revav07/Pulse-Oximeter-Project/Media/Prototype Images/Enclosure with Attached Straps.jpeg

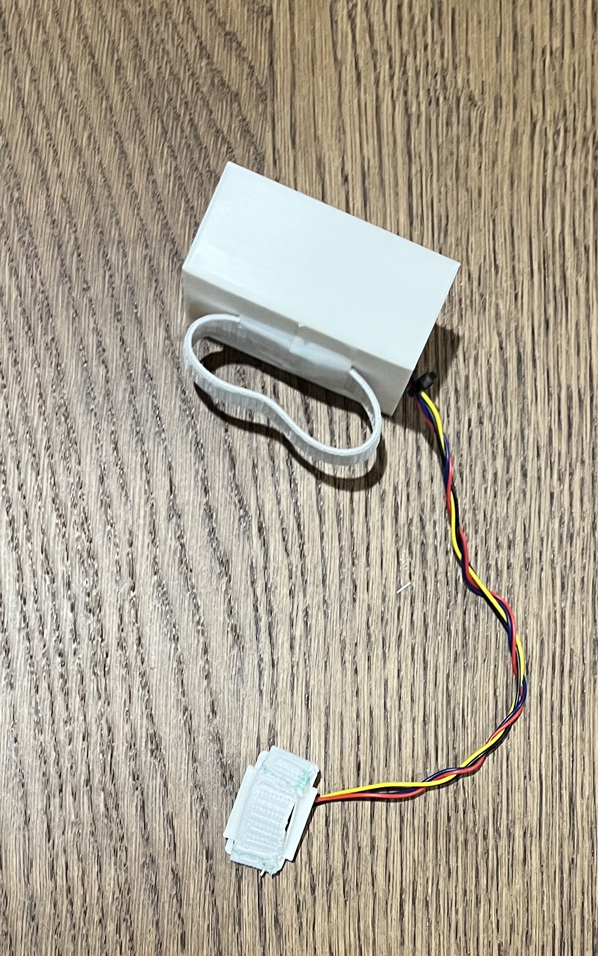
Media/Prototype Images/Enclosure with Attached Straps.jpeg
