revav07/Pulse-Oximeter-Project/Media/Prototype Images/ESP + Button.jpeg

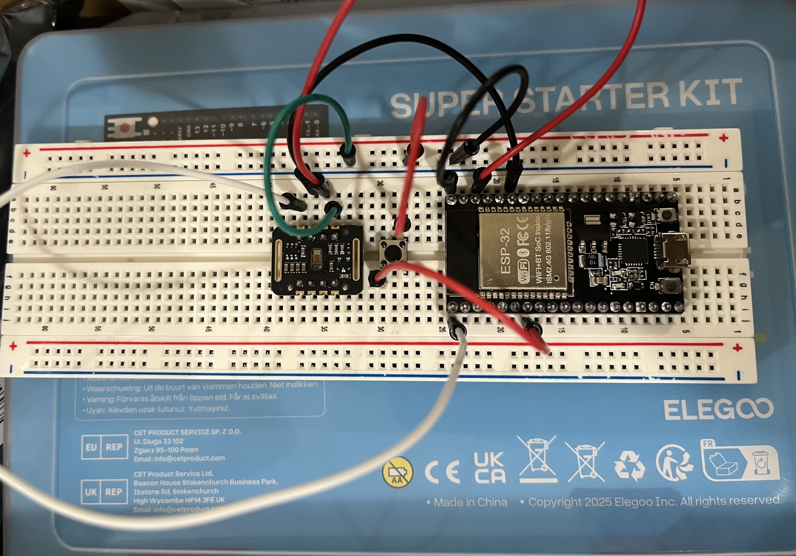
Media/Prototype Images/ESP + Button.jpeg
