revav07/Pulse-Oximeter-Project/Media/Prototype Images/Final 3D Printed Setup.jpeg

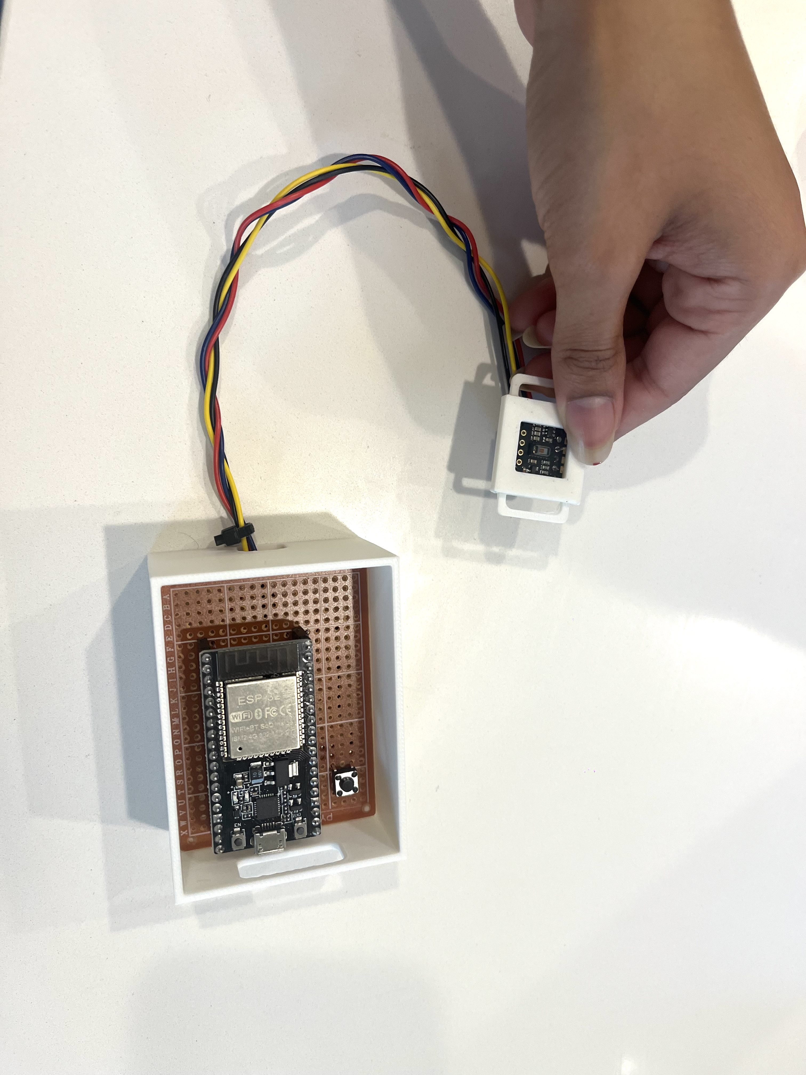
Media/Prototype Images/Final 3D Printed Setup.jpeg
