revav07/Pulse-Oximeter-Project/Media/Prototype Images/MAX + LCD setup.jpeg

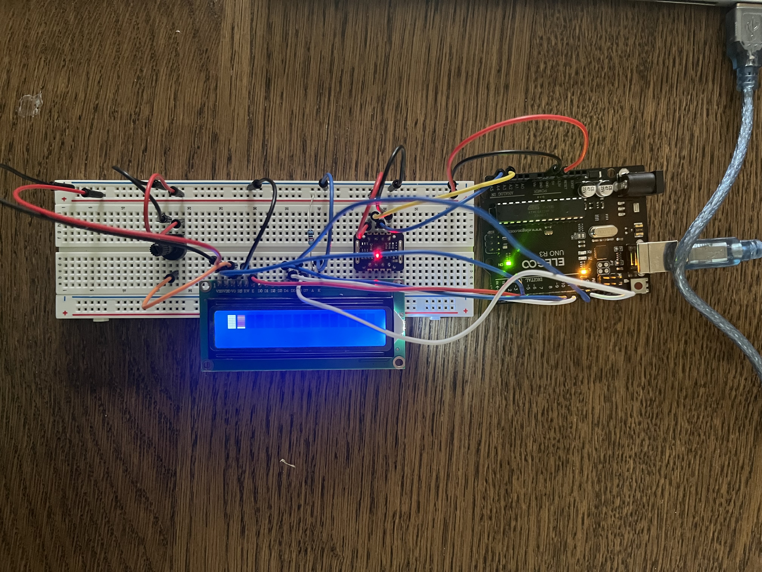
Media/Prototype Images/MAX + LCD setup.jpeg
