revav07/Pulse-Oximeter-Project/Media/Prototype Images/MAX only setup.jpeg

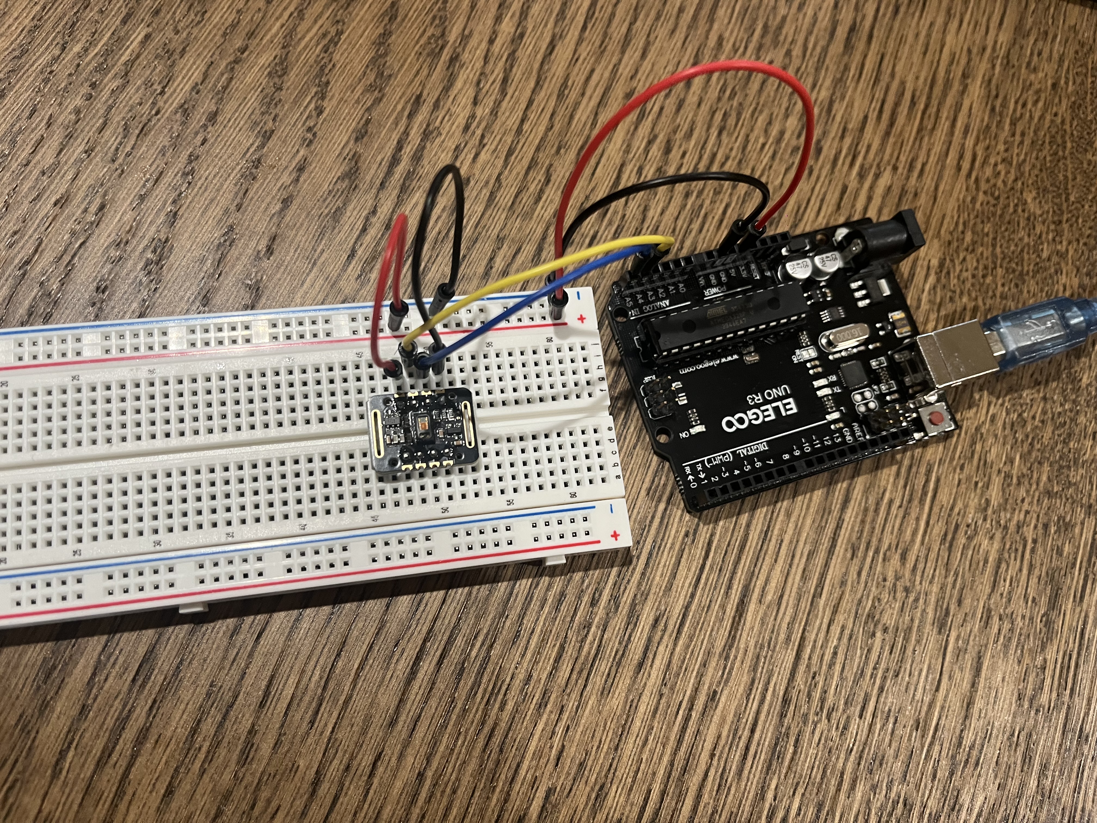
Media/Prototype Images/MAX only setup.jpeg
