revav07/Pulse-Oximeter-Project/Media/Prototype Images/Soldered MAX module.jpeg

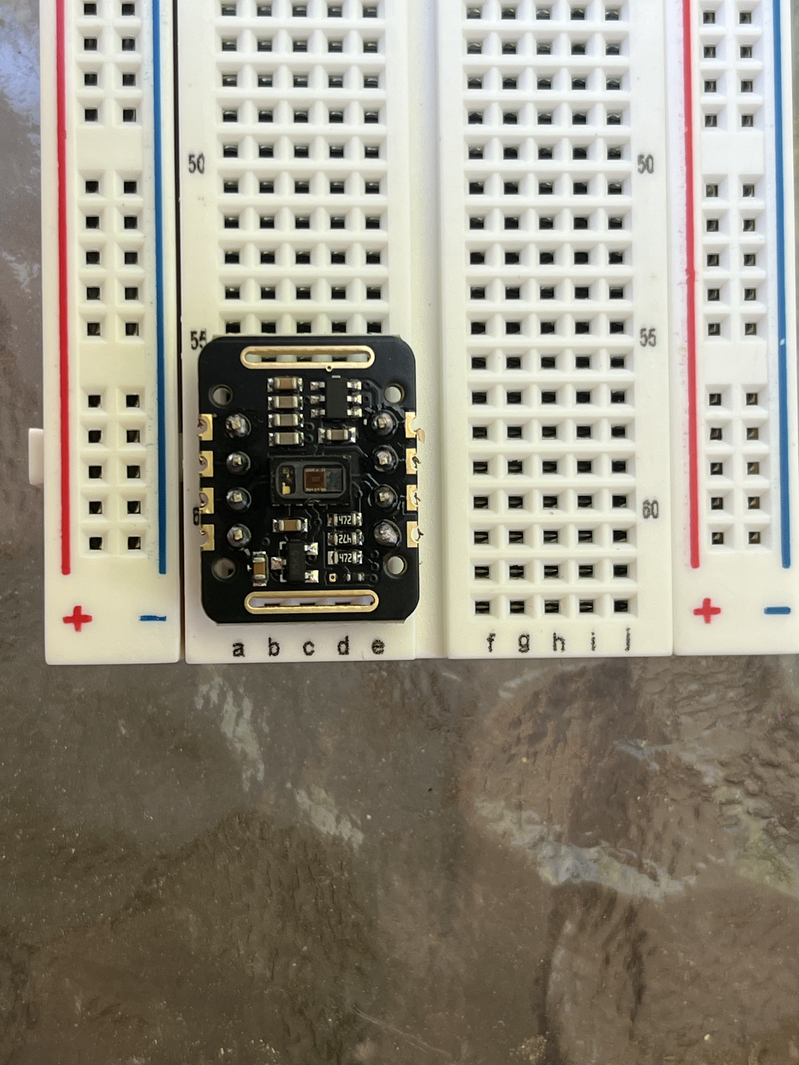
Media/Prototype Images/Soldered MAX module.jpeg
