revav07/Pulse-Oximeter-Project/(commit log)

2026-06-09 Day 4 - Smoothing out BOM Calculations
2026-06-10 Day 5 - Printout Timer and LCD Display
2026-07-08 Day 7 - Planning Wearable Prototype
2026-07-11 Day 9 - Integrating ESP32 and Streamlining BPM Code
2026-07-11 Day 9 - Integration ESP32 and Streamlining BPM Code V2
2026-07-11 Day 10 - Add Button Toggling
2026-07-23 Day 14 - 3D Printing MAX30102 Holder
