revav07/Pulse-Oximeter-Project/Media/Prototype Images/Back of Perfboard.jpeg

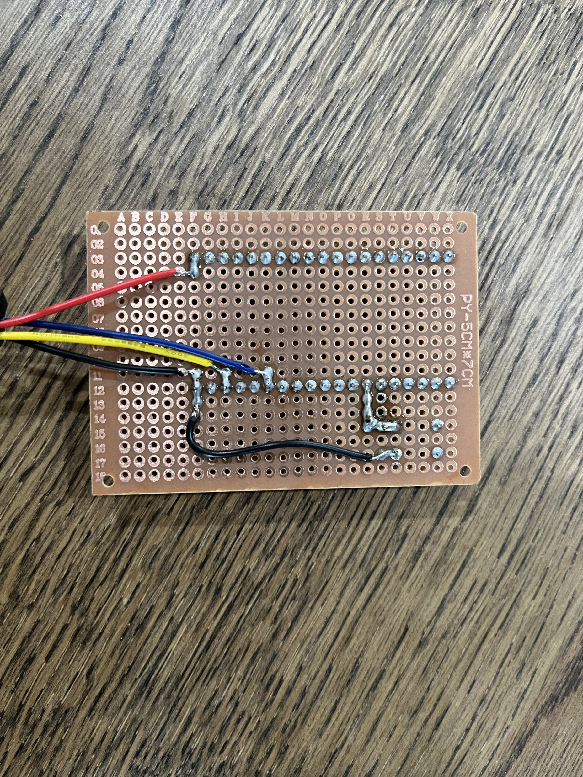
Media/Prototype Images/Back of Perfboard.jpeg
