revav07/Pulse-Oximeter-Project/Media/Prototype Images/ESP32 on Perfboard.jpeg

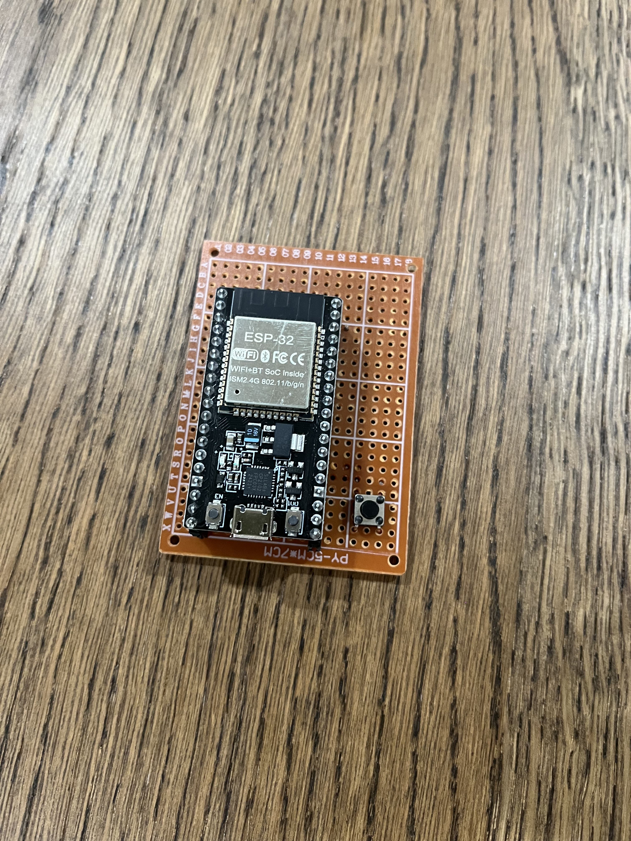
Media/Prototype Images/ESP32 on Perfboard.jpeg
