revav07/Pulse-Oximeter-Project/Media/Prototype Images/ESP config on Breadboard.jpeg

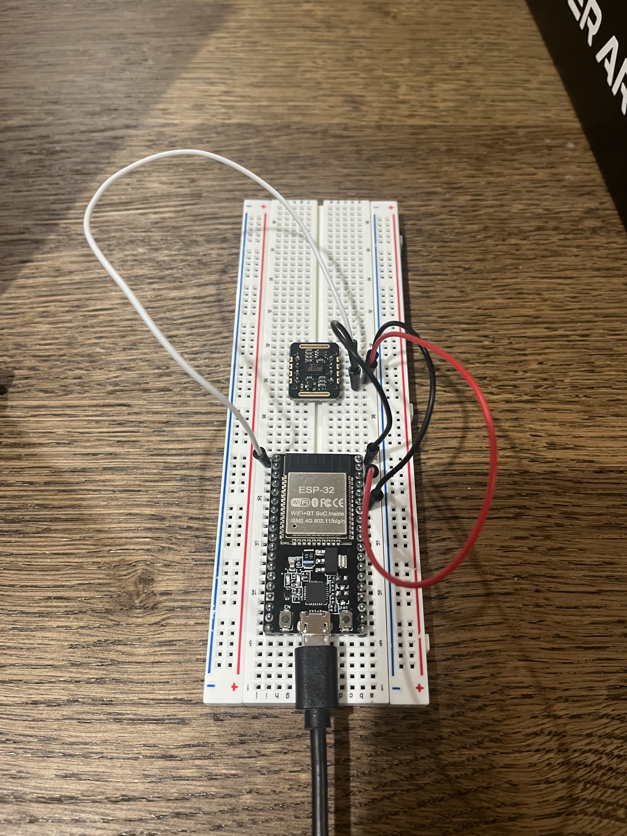
Media/Prototype Images/ESP config on Breadboard.jpeg
