revav07/Pulse-Oximeter-Project/Media/Prototype Images/Two Lid Iteration Comparison.jpeg

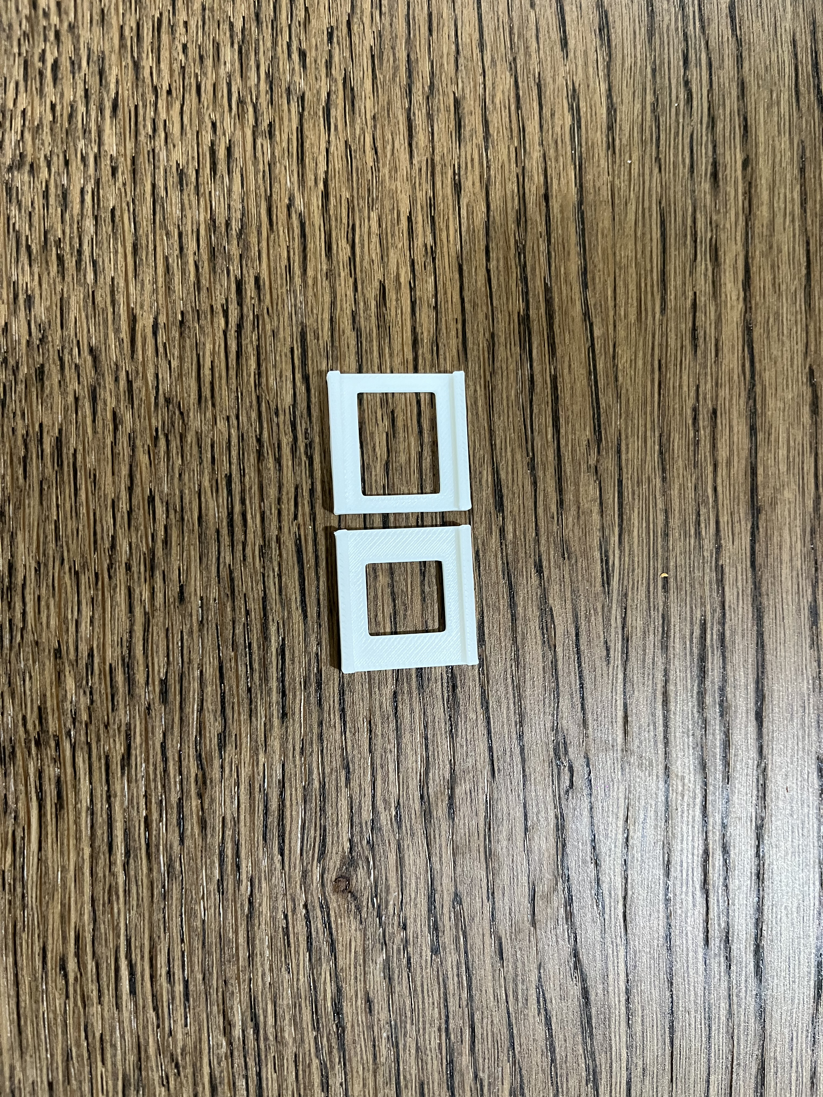
Media/Prototype Images/Two Lid Iteration Comparison.jpeg
