revav07/Pulse-Oximeter-Project/Media/Prototype Images/Soldering setup.jpeg

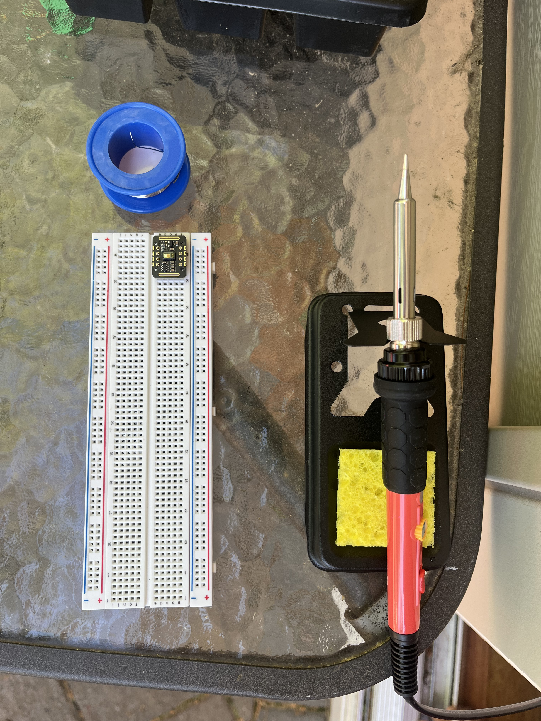
Media/Prototype Images/Soldering setup.jpeg
